Team-RocketEDA/waveform-generator/docs/layout-engine-feedback.md

# Customer review: scripting custom layout + polysilicon on the open-source flow

Reviewer: an agent that just taped out a small mixed-signal macro
(R-2R DAC + RC filter, sky130) using gdsfactory PCells, Magic, KLayout,
xschem, ngspice, and LibreLane. This is not about that project — it's
about the patterns that repeated until they became the job. Rated the way
a customer rates a toolchain: by where the hours went.

## Overall: 3 out of 5 — viable stack, hostile seams

Every individual tool works. The hours go to the gaps *between* tools:
provisioning, unit discipline, silent green checks, and device honesty.
Nothing below needs a new tool. All of it needs the engine to own the
seams instead of documenting them.

## A day in the life: the calls I actually make

Ranked by how often my fingers type them, not by importance:

| # | Call | What for | Honest frequency |
|---|---|---|---|
| 1 | `ngspice -b -o log deck` | everything: tran replays, DC sweeps, extracted sims | dozens of times a day; the inner loop |
| 2 | `xschem -x -r --rcfile … -n -s -q sch` | headless netlist as ground truth for what the GUI runs | every schematic change |
| 3 | generator scripts (`python3 gen_*.py`) | sch, GDS, decks, stitch Tcl — nothing hand-drawn | every change, by design |
| 4 | `magic -dnull -noconsole -rcfile …` piped Tcl | DRC, GDS in/out, stitch paint, extraction | a handful of times per layout rev |
| 5 | klayout region checks (`klayout.db` from Python) | second-opinion shorts/spacing DRC structurally can't see | every stitch change |
| 6 | LibreLane AppRun | digital macro only | rarely; it behaves |
| 7 | `pip install` in a side venv | working around the main env | once per machine — once too often |

Notice what's missing: I almost never click through a GUI successfully
twice. Anything I can't run headless doesn't survive the week. If an
engine leaf can't run headless, it doesn't exist to me.

## Most common pitfalls, ranked by hours lost

**1. Green checks that prove nothing.** My most expensive bug class, three
flavours: DRC 0 on wires placed at 2× scale (unit mismatch, floating in
space — only a screenshot caught it); a batch netlisterregex that silently
swallowed a stray character the real netlister choked on; same-layer
shorts that read as connections, never violations. Every green verdict
needs a stated oracle (bit-compare vs golden, rendered screenshot,
independent second implementation). A check without an oracle is a ritual.

**2. Provisioning drift.** The PCell package wants one dependency version,
the main environment ships another, so layout runs from a hand-rolled venv
in `/tmp` — outside version control, unmirrored in CI. First thing I do on
a new machine, most fragile thing I own. Toolchain compatibility is the
single most valuable thing an engine can own outright.

**3. Two netlisters, one schematic.** My strict batch expander and xschem's
real netlister disagreed on edge cases (quoting, parens, name resolution)
while agreeing on all happy paths — so everything passed until the GUI run
died. Any flow with two netlisters needs a differential check between them
or they *will* diverge. I built one; it should ship with the engine.

**4. Unit discipline across tools.** 100/um typed boxes, 200/um internal
GDS units, um-float LEF decimals, integer-only Tcl emission. Every boundary
needs an assert, because the failure mode is always "correct, but 2×" with
a passing check suite.

**5. Text purposes and pin names.** GDS text choked one backend, so my pins
shipped as anonymous squares with function living in comments. Three tools,
three text conventions, zero stated contracts. Pin-name round-trip across
backends should be a conformance test, not a hope.

**6. Schematic device ≠ layout device.** I simulated one PDK resistor model
and drew another vendor PCell with the same dimensions. Ratios matched,
identity didn't, LVS was pending — so a passing DNL proved nothing about
the GDS for a stretch. Nobody asserts sim-model ↔ drawn-device
correspondence today. That assertion is the whole ballgame for analog.

**7. Mirror-by-comment.** Two generators sharing values through a comment
("lengths mirror …") drifted within one revision: three surrounding numbers
rotted while the lengths held. Electrical values need one home or one
equivalence check. Comments are not homes.

**8. Hand-transcribed rule tables.** Via cut/pitch/enclosure copied from
LEF GENERATE rules into dict literals. Works, DRCs clean, rots silently on
the next PDK point-release. I needed queryable rules; I had grep.

**9. Half-manual extraction.** Everything before and after parasitic
extraction is scripted; the extraction click itself is "interactive".
Unrepeatable in CI by definition. Device-mapping custom poly for the
extractor is the Rust-belt part nobody paves.

**10. PCell opacity.** Port names found by printing, param names differing
from the schematic's (`res_width` vs `W`), guard-ring policy unknown,
zero DRC footnotes. Placing cells I can't introspect feels like importing
binaries — because it is.

## Times I wished for an easier tool (the actual moments)

- **Hour 0, new machine:** "give me a working PCell environment." What I
  did: `python3 -m venv /tmp/gfsky130 && pip install -r requirements…`
  and prayed. What I wanted: one resolve call (PDK rev × tool versions ×
  venv recipe), echoed back in every run answer.
- **Every schematic edit:** "prove the GUI sees what I see." What I did:
  headless `xschem -n`, diff device lines against my expander, run both
  decks, bit-compare 53k rows. What I wanted: netlist-equivalence as a
  shipped check kind.
- **Every strap I painted in Magic:** "is this on my pin or in space?"
  What I did: Python asserts pre-paint + klayout region audit post-paint
  + screenshot eyeball. What I wanted: paint-with-asserts as one
  operation, with the unit assert at the boundary.
- **Every resistor I drew:** "is this the device I simulated?" What I
  did: eyeballed two files in one afternoon. What I wanted: a
  sim-model↔drawn-device correspondence check, or one topology object
  emitting both.
- **Every PCell I touched:** "what are your params, ports, and caveats?"
  What I did: print statements and trial DRC. What I wanted: a queryable
  cell browser. Finding `PLUS`/`MINUS` via `print(ports)` is embarrassing
  for all of us.
- **Every long sim:** "how long will this take and did it move?" What I
  did: `yield` waits and log tails. What I wanted: wall-time + peak-RSS
  on every job status. (No cloud here — dollars never enter it; minutes
  and gigabytes do.)
- **Every seam, always:** "let me just run the raw tool." What I did:
  Python + shell around everything, kept honest by a personal
  scratch-vs-results discipline. What I wanted: a console escape with env
  parity (same binaries, same PDK, same venvs), timeouts, and artifact
  write-back — plus rewind-as-undo when the escape goes wrong.

## What I'd tell the engine team, in order

1. **Own provisioning end to end** (compat matrix, venvs, resolved-config
   echo). Biggest hours-per-line-of-code item on this list.
2. **Ship the differential checks**: netlister-vs-netlister,
   sch-vs-layout params, sim-model-vs-drawn-device. My whole verification
   methodology is three of these; none ships today.
3. **Encode the Magic runbook, don't link it**: import order, unit
   asserts, `load`-not-`create`, crash guards. Each footgun is a
   regression test — take them.
4. **State the text-purpose contract per backend**, with pin-name
   round-trip tests. Comments are not a pinout.
5. **Queryable rules and cells** (via tables, PCell schemas + footnotes).
   grep is not a rule deck.
6. **Construction helpers over raw polygons** (strap, trunk, via stack,
   labelled pad). My 60-line helper block shouldn't need to exist.
7. **Keep the escape hatch Python, with rewind as the safety story.**
   Every item above was crossed with Python + shell. The hatch absorbs
   the long tail so the leaves stay small — that's how Magic keeps its
   command set sane, and it's the correct division of labour here too.

## What worked (would buy again)

gdsfactory PCells do produce DRC-clean analog; Magic batch mode is
scriptable once known; klayout regions catch what DRC structurally
cannot; LibreLane macros drop in without drama; `alter`-based DC sweeps
turn 256 codes into one run. The toolchain is viable end to end. Charge
me for the tools; fix the seams for free.
