Team-RocketEDA/waveform-generator/exports/README.md

# exports/ — manufactured-output candidates (GDS/OASIS + screenshots).
# Binaries are gitignored; keep the PNG screenshot + a provenance note
# (source rev, PDK rev, tool versions) with every GDS.
