Team-RocketEDA/waveform-generator/exports/tb_map.png

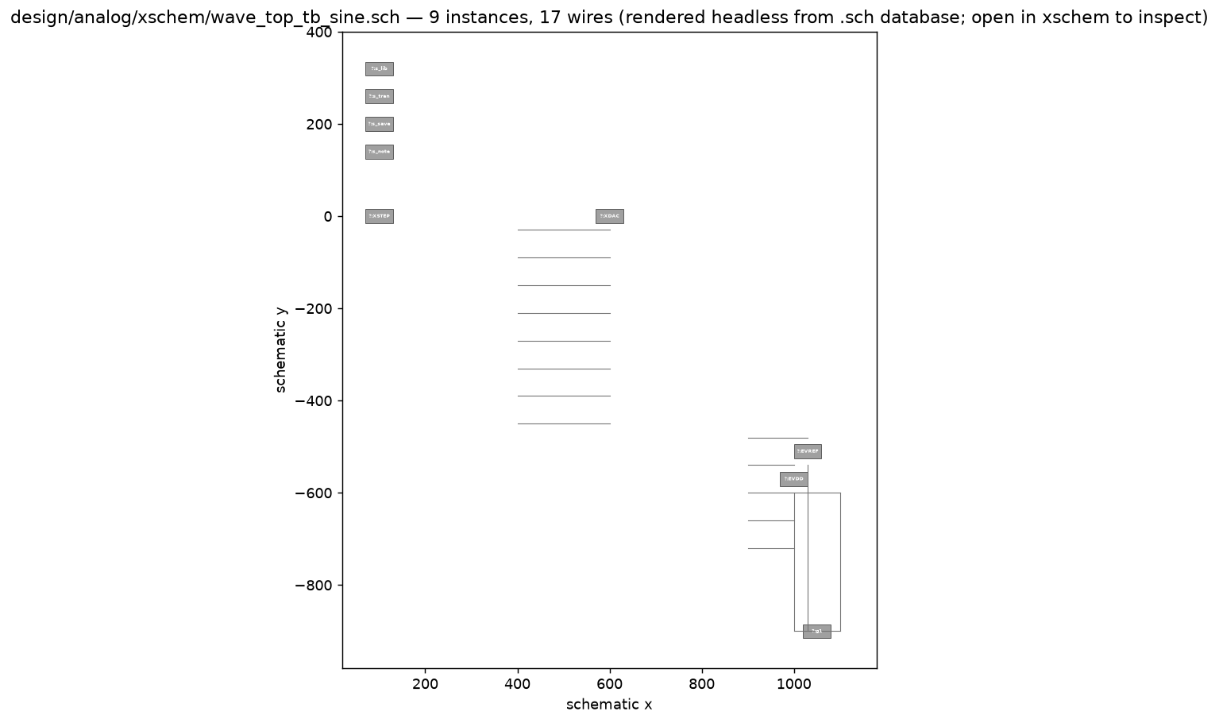
exports/tb_map.png
