Team-RocketEDA/waveform-generator/exports/tb_replay_saw.png

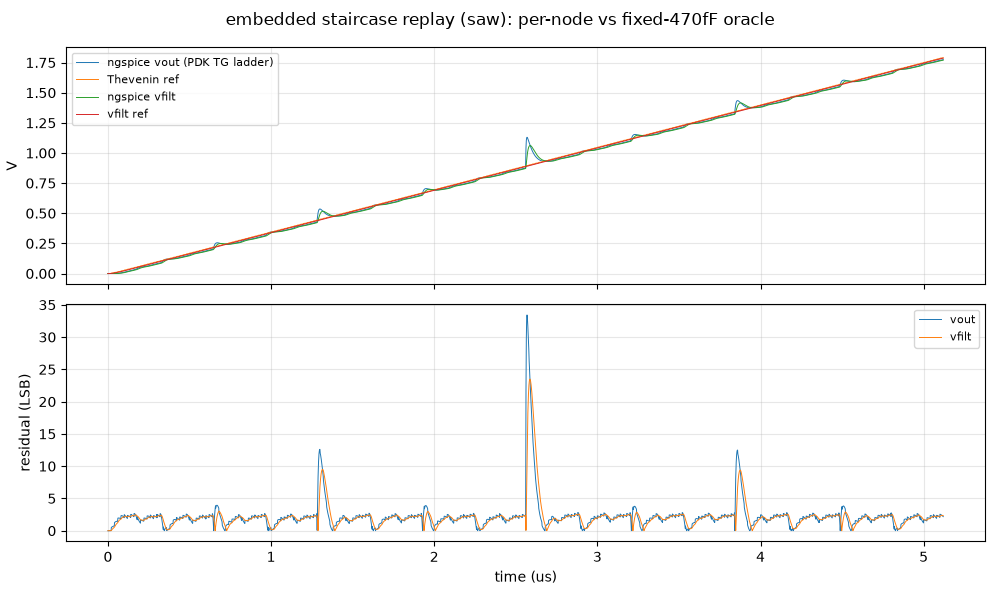
exports/tb_replay_saw.png
