Team-RocketEDA/waveform-generator/exports/tb_replay_sine.png

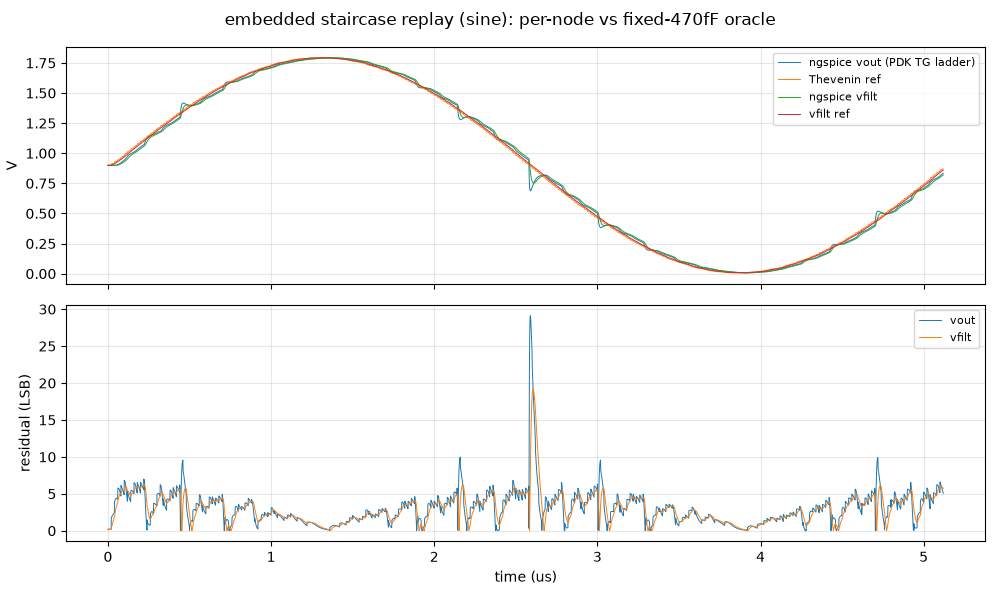
exports/tb_replay_sine.png
