Team-RocketEDA/waveform-generator/results/README.md

# results/ — run exhaust (gitignored). Every check records target, measured
# value, status, source rev, PDK, tool/version, log reference alongside the
# raw file. Regenerate with `make rtl tran dnl plot`. Handwritten sources
# never live here.
