Team-RocketEDA/waveform-generator/results/pdk_dc.spice

* pdk DAC DC sweep: 256 codes, TG muxes, endpoint-fit DNL/INL
.lib /home/alrida-ismail/.local/share/pdk/sky130A/libs.tech/ngspice/sky130.lib.spice tt
.temp 27
.include design/analog/xschem/r2r_dac8_pdk.spice
Vb0 b0 0 DC 0
Vb1 b1 0 DC 0
Vb2 b2 0 DC 0
Vb3 b3 0 DC 0
Vb4 b4 0 DC 0
Vb5 b5 0 DC 0
Vb6 b6 0 DC 0
Vb7 b7 0 DC 0
Vvref vref 0 DC 1.8
Vvpwr vpwr 0 DC 1.8
Vvgnd vgnd 0 DC 0
.control
alter @Vb0[dc] = 0.0
alter @Vb1[dc] = 0.0
alter @Vb2[dc] = 0.0
alter @Vb3[dc] = 0.0
alter @Vb4[dc] = 0.0
alter @Vb5[dc] = 0.0
alter @Vb6[dc] = 0.0
alter @Vb7[dc] = 0.0
op
echo CODE 0 $&vout
alter @Vb0[dc] = 1.8
alter @Vb1[dc] = 0.0
alter @Vb2[dc] = 0.0
alter @Vb3[dc] = 0.0
alter @Vb4[dc] = 0.0
alter @Vb5[dc] = 0.0
alter @Vb6[dc] = 0.0
alter @Vb7[dc] = 0.0
op
echo CODE 1 $&vout
alter @Vb0[dc] = 0.0
alter @Vb1[dc] = 1.8
alter @Vb2[dc] = 0.0
alter @Vb3[dc] = 0.0
alter @Vb4[dc] = 0.0
alter @Vb5[dc] = 0.0
alter @Vb6[dc] = 0.0
alter @Vb7[dc] = 0.0
op
echo CODE 2 $&vout
alter @Vb0[dc] = 1.8
alter @Vb1[dc] = 1.8
alter @Vb2[dc] = 0.0
alter @Vb3[dc] = 0.0
alter @Vb4[dc] = 0.0
alter @Vb5[dc] = 0.0
alter @Vb6[dc] = 0.0
alter @Vb7[dc] = 0.0
op
echo CODE 3 $&vout
alter @Vb0[dc] = 0.0
alter @Vb1[dc] = 0.0
alter @Vb2[dc] = 1.8
alter @Vb3[dc] = 0.0
alter @Vb4[dc] = 0.0
alter @Vb5[dc] = 0.0
alter @Vb6[dc] = 0.0
alter @Vb7[dc] = 0.0
op
echo CODE 4 $&vout
alter @Vb0[dc] = 1.8
alter @Vb1[dc] = 0.0
alter @Vb2[dc] = 1.8
alter @Vb3[dc] = 0.0
alter @Vb4[dc] = 0.0
alter @Vb5[dc] = 0.0
alter @Vb6[dc] = 0.0
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
op
echo CODE 152 $&vout
alter @Vb0[dc] = 1.8
alter @Vb1[dc] = 0.0
alter @Vb2[dc] = 0.0
alter @Vb3[dc] = 1.8
alter @Vb4[dc] = 1.8
alter @Vb5[dc] = 0.0
alter @Vb6[dc] = 0.0
alter @Vb7[dc] = 1.8
op
echo CODE 153 $&vout
alter @Vb0[dc] = 0.0
alter @Vb1[dc] = 1.8
alter @Vb2[dc] = 0.0
alter @Vb3[dc] = 1.8
alter @Vb4[dc] = 1.8
alter @Vb5[dc] = 0.0
alter @Vb6[dc] = 0.0
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
