Team-RocketEDA/waveform-generator/(commit log)

2026-11-02 Project manifest, constraints, and EDA ignores
    rocket.yaml pins blocks/PDK/testbenches, canvas.toml sets the
    50 MHz / 1.8 V / 8-bit / DNL-INL targets.
2026-11-02 8-bit RTL waveform generator with generated sine ROM
    Phase accumulator plus sine/saw/triangle mux, synth-safe case ROM
    from one source, Icarus testbench dumping per-mode code streams.
2026-11-02 Ideal-switch R-2R DAC, RC filter, and top assembly
    spice_blocks with canonical pin order; analyses stay in the
    harness, transistor revision comes later.
2026-11-02 chore(flow): add Makefile, workflow bindings, and doc stubs
    Contract-only gds/arch targets; engine task bindings for the
    digital and analog flows; L0 board and IP registry placeholders.
2026-11-02 feat(synth): add yosys smoke recipe and LibreLane config
    Mapped netlist hits 2155 um2 in sky130_fd_sc_hd; Classic flow
    config with explicit corner-to-liberty map for manual PDK root.
2026-11-02 fix(rc): lighten reconstruction filter to 3.4 MHz
    1k plus 47p leaves ~3 deg shift and ~50 ns delay on the
    195 kHz fundamental; agreement re-verified at 0.09 LSB.
2026-11-02 fix(synth): pin SYNTH_CORNER and DEFAULT_CORNER to tt
    Manual PDK root leaves DEFAULT_CORNER as nom_, which matches
    zero LIB keys and starves yosys of liberty files.
2026-11-02 chore(git): ignore LibreLane runs and exported views
    Regenerable flow exhaust stays out of history; deliverables
    stay explicit (gds_shot.png, PROVENANCE.md).
2026-11-02 test(sim): refresh waveform agreement after filter change
    Light RC re-verified at 0.09/0.04 LSB; verdict file updated.
2026-11-02 feat(stitch): scripted Magic stitch with independent checks
    LEF-driven strap/via generator with overlap and clearance
    asserts, klayout full-metal short/spacing verifier, headless
    GDS renderer. make stitch runs gen, verify, DRC, plot.
2026-11-02 docs(arch): archify top + 3 stage boards with port widths
    Top board shows LUT -> R-2R -> LPF as separate blocks; one drill-down
    page per stage. Candidates in .archify/ for re-finalize.
2026-11-02 test(pex): extracted-GDS transistor sim proves waveform codes 20/20
    Magic flat extract of stitch_top (3224 FETs + 88 node caps) simulated
    24 clocks in sine mode; strap nets match RTL golden codes exactly.
    Adds make pex path, writeup docs/pex_sim.md, plot exports/pex_wave.png.
2026-11-03 PDK ladder rev2: xschem gen + touchcheck + 256-code DC sweep PASS (DNL 0.22 INL 0.19 LSB)
    [r2r_dac8_pdk.sch]
2026-11-03 README showcase: schematic map, layout tile, metrics, plots, run guide
2026-11-03 Embedded xschem tb: PWL staircase replay + Thevenin-oracle check PASS
    [wave_top_tb.sch]
2026-11-03 Replay vs fixed-470fF oracle: saw PASS both nodes, sine p95 6.0/5.6
    [wave_top_tb_saw.sch, wave_top_tb_sine.sch]
2026-11-03 Hierarchical tb: stepper block + DAC top per mode
    [stair_stepper_saw.sch, stair_stepper_sine.sch, wave_top_tb_saw.sch, wave_top_tb_sine.sch]
2026-11-03 Visitor tb schematics expand to bit-identical decks (make tbexpand)
    gen_tb_sch: supplies/outputs routed at DAC pin rows (was 30 off,
    floated vref/vpwr/vgnd/vfilt/vout), V-named sources, tri tb added.
    expand_tb: strict hierarchy expander with pin-order checks, open/short
    asserts, ground canonicalization, single .lib (reload breaks numparams).
    run_expanded: sine/saw bit-identical vs flat replay; tri runs clean.
    [stair_stepper_saw.sch, stair_stepper_sine.sch, stair_stepper_tri.sch, wave_top_tb_saw.sch, wave_top_tb_sine.sch, wave_top_tb_tri.sch]
2026-11-03 Embedded in-schematic plot in visitor tbs (graph rect + launcher + .control)
    Foundry-tb pattern (gf180mcu test_*.sch): B rect with flags=graph,
    dataset=-1 renders v(vout)/v(vfilt) in the schematic; Ctrl+click on the
    launcher loads <sch>.raw; the sim recipe rides in a visible code_shown
    .control block (save/run/write/wrdata). Batch proves the same block:
    run_expanded executes the schematic's own .control, sine/saw stay
    bit-identical vs the flat replay. expand/plot/touchcheck parsers handle
    multiline {...} records now.
    [wave_top_tb_saw.sch, wave_top_tb_sine.sch, wave_top_tb_tri.sch]
2026-11-03 README: visitor flow uses embedded graph + launcher, no Add Wave
2026-11-03 One-button tb sim: pin dirs, opin probes, auto-plot
    r2r_dac8_pdk.sym used dir=inout everywhere; xschem hard-errors
    (ipin<->in, opin<->out per netlist.c) and refuses to netlist. The
    generator now mirrors DAC sch port types (11x in, 2x out).
    Probe stubs were single-pin nets (ERC open-net warnings); each stub
    now ends in an opin that names the net for .save/graph.
    s_sim .control ends with plot v(vout) v(vfilt): one Simulate press
    pops the waves, no typing. Batch ignores plot cleanly (proven in log).
    expand_tb gains the same dir-correspondence assert for DAC + stepper.
    [wave_top_tb_saw.sch, wave_top_tb_sine.sch, wave_top_tb_tri.sch]
2026-11-03 README: visitor flow is one Simulate press with auto-plot
2026-11-03 Fix GUI sim kill: stray paren in s_tran + xschem-native proof
    s_tran attrs ended with a stray ')' that xschem emitted into the
    netlist ('.tran 100p ...)') while the batch expander stayed green.
    expand_tb now fails on parens outside code values (same divergence).
    New make tbxschem (scripts/run_gui_netlist.py): netlist the visitor
    tbs with real xschem headless, run, require bit-identical traces vs
    the flat replay — sine/saw 0.0 diff, tri clean.
    [wave_top_tb_saw.sch, wave_top_tb_sine.sch, wave_top_tb_tri.sch]
2026-11-03 Run on any machine, and say what the stitched top actually contains
    The Makefile, scripts and LibreLane config hardcoded one person's home folder and
    /tmp tool paths, so several targets only worked there. PDK_ROOT, ENGINE_PY,
    LIBRELANE and GFSKY130_PY now cover them, with the old layout as the default where
    possible. ENGINE_PY also finds the engine from inside RocketIDE/Demos/.
    The README said the repo holds the stitched GDS and that the chain is proven. That
    GDS is a gitignored build output, and stitch_top contains the digital macro and its
    straps, not the analog macro. It now says so up front.
